quicksilv3rflash/ELF_sensor/ELF_sensor/Capture du 2022-08-07 16-23-05.png

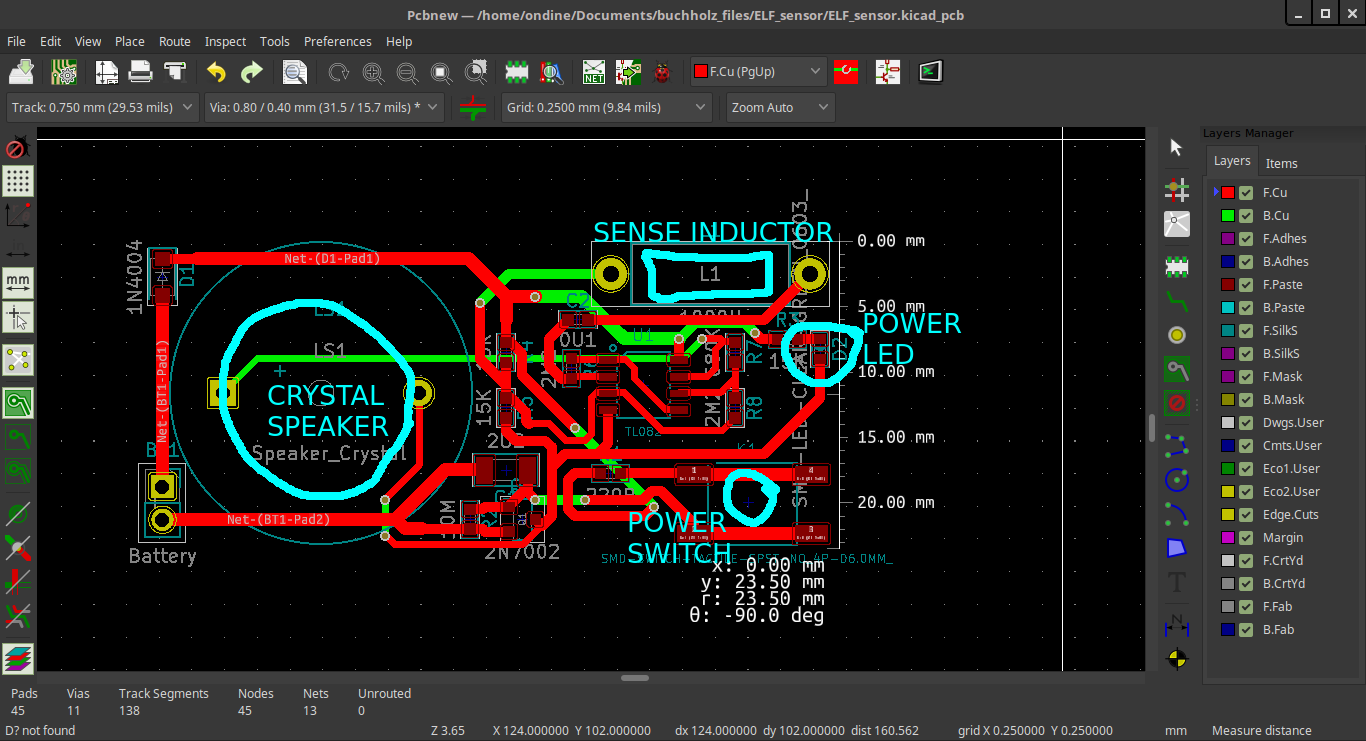
ELF_sensor/Capture du 2022-08-07 16-23-05.png
