quicksilv3rflash/ELF_sensor/ELF_sensor/ELF_ASSEMBLY_INSTRUCTIONS/ELF_ASSEMBLY_DRAWING.pdf

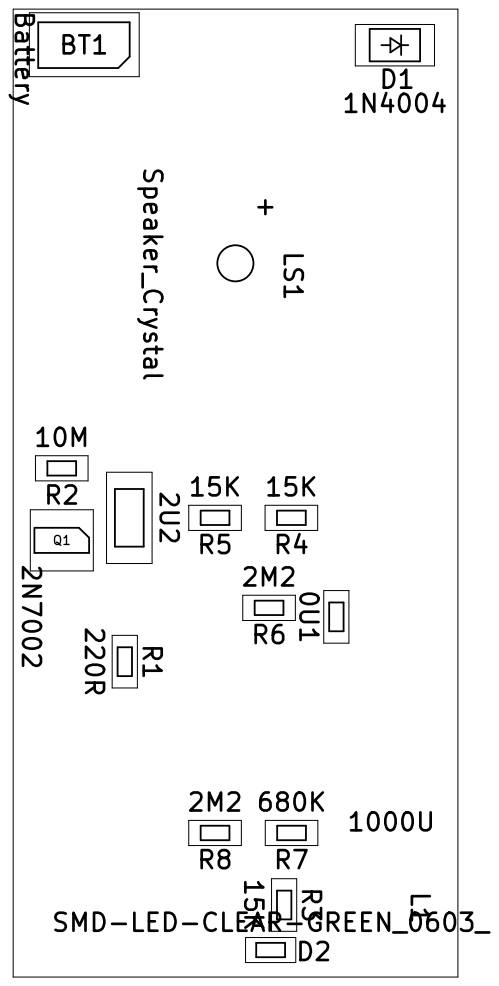
[picture p2: page 1]
