quicksilv3rflash/ELF_sensor/ELF_sensor/ELF_sensor.kicad_pcb

## KiCad design ELF_sensor/ELF_sensor.kicad_pcb (2026-04-09)

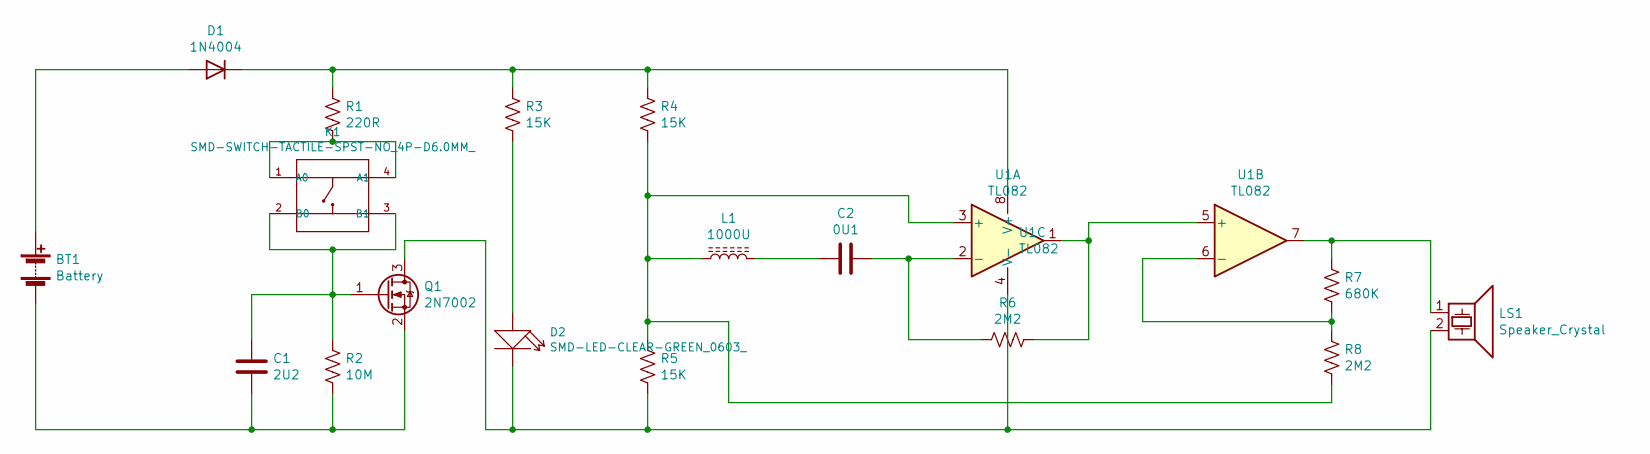
[picture p3: schematic ELF_sensor.sch]

Parts:
BT1: Battery; PinSocket_1x02_P2.54mm_Vertical
C1: 2U2; C1206
C2: 0U1; C0603
D1: 1N4004; D_SOD-123F
D2: SMD-LED-CLEAR-GREEN_0603_; LED-0603; MPN 19-217-G7C-AN1P2-3T
K1: SMD-SWITCH-TACTILE-SPST-NO_4P-D6.0MM_; DTSM-62K-S-V-T_R_SN431; MPN DTSM-62K-S-V-T_R_SN431_
L1: 1000U; L_Radial_D7.5mm_P2.5mm
LS1: Speaker_Crystal; HNR-2310A
Q1: 2N7002; SOT-23
R1: 220R; R0603
R2: 10M; R0603
R3, R4, R5: 15K; R0603
R6, R8: 2M2; R0603
R7: 680K; R0603
U1: TL082; SOIC8-1.27-5X4MM

Connections:
unnamed: BT1.1 (+), D1.2 (A)
unnamed: BT1.2 (-), C1.2, Q1.2 (S), R2.2
unnamed: C1.1, K1.2 (B0), K1.3 (B1), Q1.1 (G), R2.1
unnamed: C2.1, R6.2, U1.2 (-)
unnamed: C2.2, L1.2
unnamed: D1.1 (K), R1.1, R3.1, R4.1, U1.8 (V+)
unnamed: D2.1 (+), R3.2
unnamed: D2.2 (-), LS1.2, Q1.3 (D), R5.2, U1.4 (V-)
unnamed: K1.1 (A0), K1.4 (A1), R1.2
unnamed: L1.1, R4.2, R5.1, R8.2, U1.3 (+)
unnamed: LS1.1, R7.1, U1.7
unnamed: R6.1, U1.1, U1.5 (+)
unnamed: R7.2, R8.1, U1.6 (-)

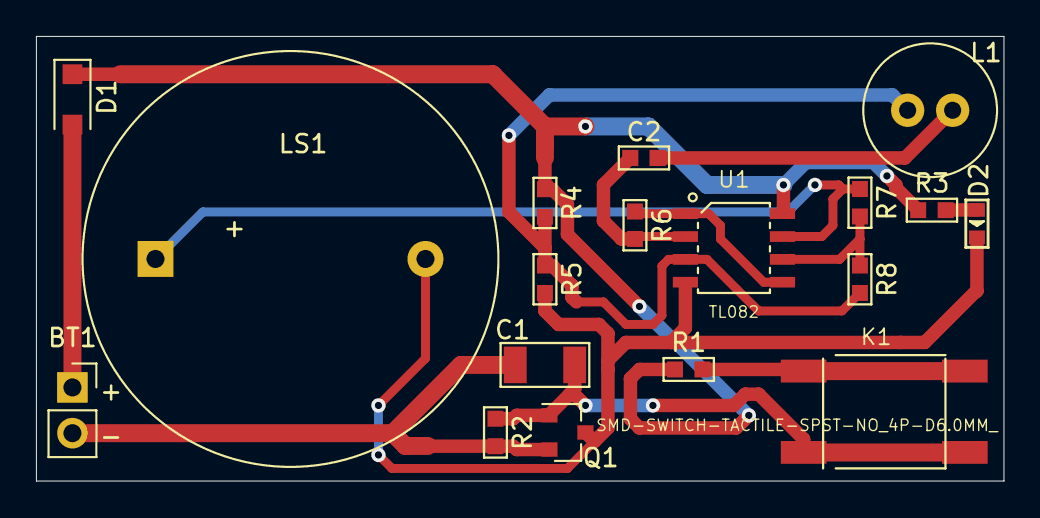
[picture p4: board ELF_sensor.kicad_pcb from above]

Board: 2 copper layers, 53.8 x 24.7 mm, 18 parts (0 on the bottom side), 13 nets.
